prueba2001/UAV-CONTROLADO-POR-4G-LTE/README.md

https://drive.google.com/file/d/1UdGnhi0XhoKIerkP7uhXoAIDbuv5v3hw/view?usp=sharing
Calculos aerodinamicos previos
