prueba2001/UAV-CONTROLADO-POR-4G-LTE/ArchivosCAD/Planos/Ala_huecos_servos.pdf

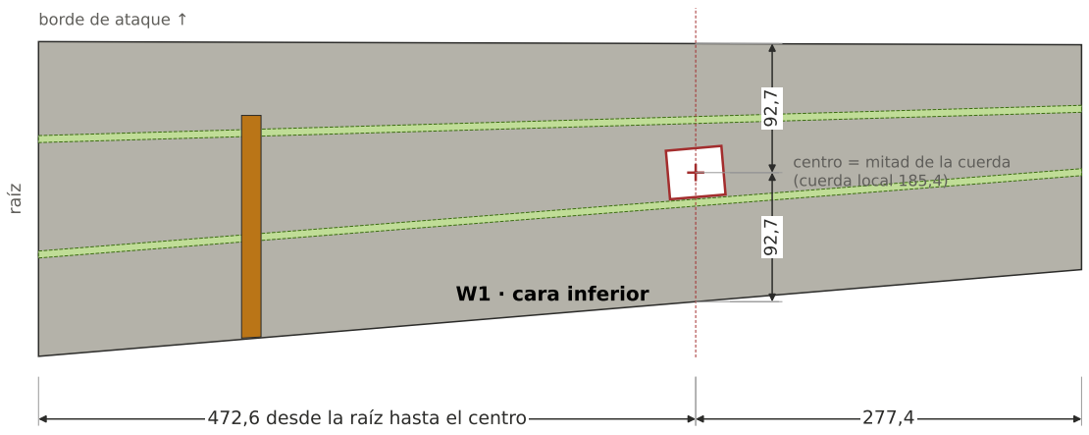
[picture p22: figure]
centro = mitad de la cuerda (cuerda local 185,4); raíz; borde de ataque ↑; W1 · cara inferior

472,6 desde la raíz hasta el centro | 277,4 ⁹²,7 92,7

Escala 1:5

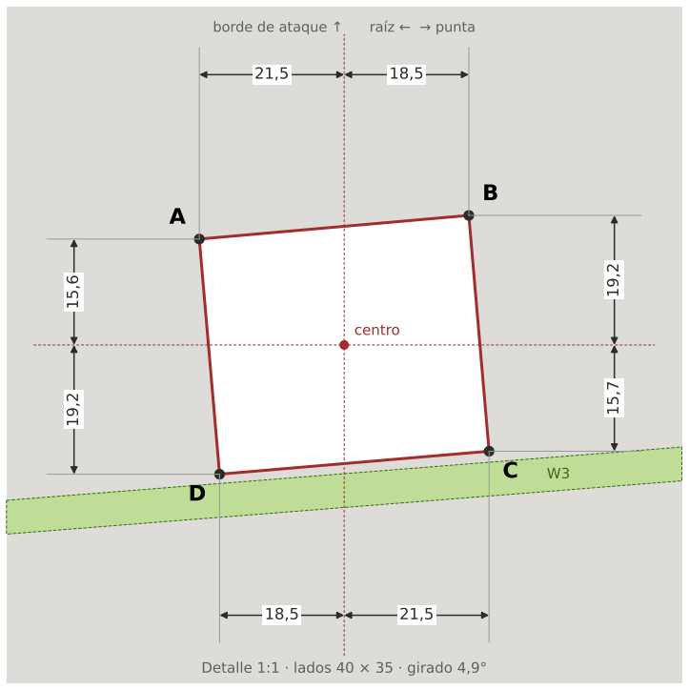
[picture p23: figure]
centro; borde de ataque ↑ raíz ← → punta

Detalle 1:1 · lados 40 × 35 · girado 4,9°

50 mm: imprime al 100 %

# Huecos de los servos de alerón — referencia: centro y vértices

W1 vista desde abajo, borde de ataque arriba. Marca primero el centro y desde él los vértices A, B, C, D.

UAV Alapalap 4S · medidas tomadas del plano A0 de Julius Perdana (Paper Replika) · cotas en mm

## Coordenadas (mm)

Punto | Desde la raíz | Desde el b. de ataque

Desde centro:
hacia la punta

Desde centro:
hacia b. de fuga | Posición
Centro | 472,6 | 92,7 | 0 | 0 | mitad del hueco
A | 451,1 | 77,1 | − 21,5 | − 15,6 | delantero · lado raíz
B | 491,0 | 73,4 | + 18,5 | − 19,2 | delantero · lado punta
C | 494,0 | 108,3 | + 21,5 | + 15,7 | trasero · lado punta
D | 454,1 | 111,8 | − 18,5 | + 19,2 | trasero · lado raíz

Cómo marcarlo en W1 (con la pieza boca abajo)
1. Desde la raíz mide 472,6 mm a lo largo del borde de ataque y traza ahí una línea perpendicular al borde de ataque.
2. Sobre esa línea mide 92,7 mm desde el borde de ataque: ese es el centro. (Comprueba: también debe quedar a 92,7 del borde de fuga.)
3. Desde el centro marca cada vértice con la tabla: primero el desplazamiento hacia la punta (− = hacia la raíz) y luego hacia el borde de fuga (− = hacia adelante).
4. Une A-B-C-D. Comprueba: lados AB y CD = 40, lados BC y DA = 35, y el lado C-D queda paralelo y a 1,5 mm de la franja de W3.
Semiala izquierda: mismos números (la pieza es espejo). Los valores salen del plano A0 y coinciden con el hueco del DXF W1_W5.

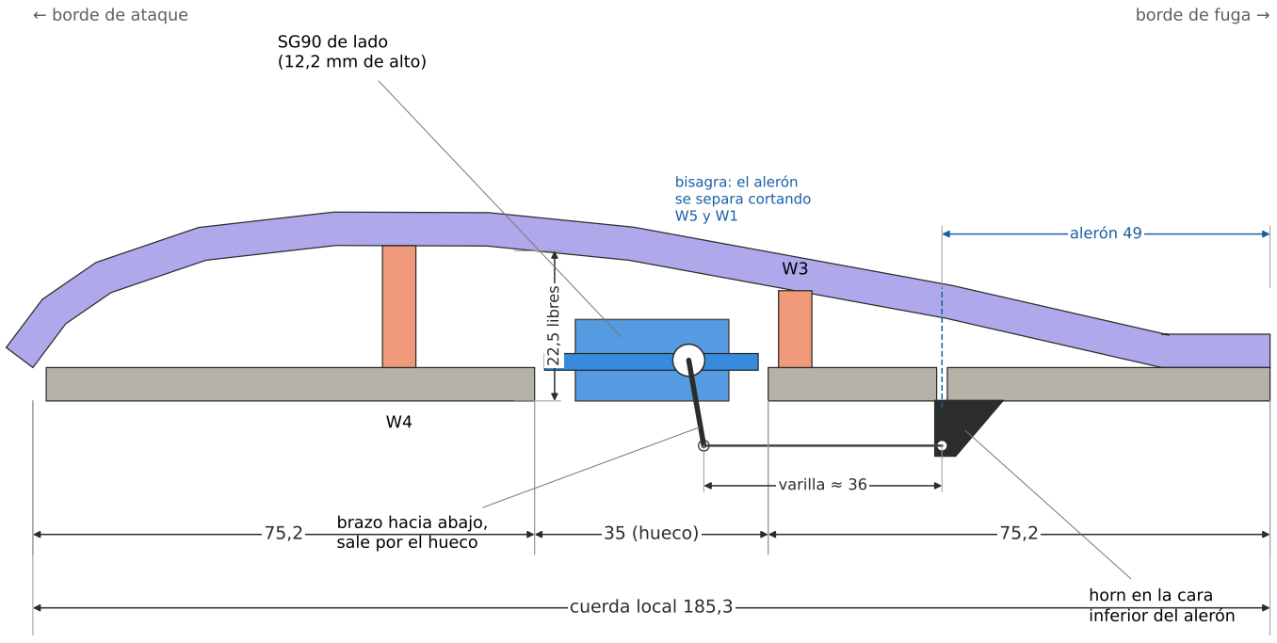
[picture p24: figure]
35 (hueco); cuerda local 185,3; alerón 49; varilla ≈ 36; 22,5 libres; SG90 de lado (12,2 mm de alto); brazo hacia abajo, sale por el hueco; horn en la cara inferior del alerón; bisagra: el alerón se separa cortando W5 y W1; ← borde de ataque; borde de fuga →
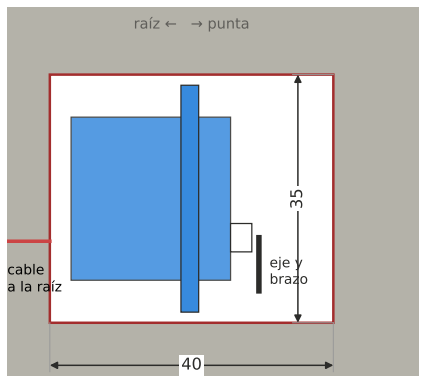
[picture p25: figure]
cable a la raíz; raíz ← → punta; eje y brazo

Vista desde abajo 1:1
(borde de ataque arriba)

Regla de control 50 mm · imprime al 100 %

# Corte por el centro del hueco (a 472,6 mm de la raíz) — escala 1:1

Servo SG90 acostado de lado dentro del hueco: el eje queda horizontal (hacia la punta) y el brazo asoma por debajo para empujar la varilla.

UAV Alapalap 4S · medidas tomadas del plano A0 de Julius Perdana (Paper Replika) · cotas en mm

Por qué de lado: a esa altura de la cuerda el ala tiene entre 17 y 22 mm de alto por dentro (contando el espesor de W1). Un SG90 parado mide 22,7 mm más el eje y no cabe; acostado mide 12,2 mm, entra entero y su base queda a ras de la cara inferior. El hueco de 35 mm (en el sentido de la cuerda) aloja las orejas de 32 mm, y los 40 mm
(en el sentido de la envergadura) alojan el cuerpo de 22,7 mm más el brazo.

Montaje
1. Corta el hueco en W1 antes de pegar W5. Centra el servo antes de instalarlo (90°, con el Pico o un probador de servos).
2. Mete el servo de lado con el eje hacia la punta; pega las orejas a los bordes del hueco con silicona o pegamento caliente a baja temperatura (que se pueda desmontar).
3. Pasa el cable por dentro, entre W4 y W3, hasta la raíz; usa un alargador de 30 cm y abre en W2 una ranura de ≈ 10 × 5 mm para sacarlo hacia la góndola.
4. Pega el horn en la cara inferior del alerón, con sus agujeros alineados con la bisagra y en línea recta con el brazo del servo.
5. Varilla de acero de 1 mm con un doblez en Z en el servo y un clip o doblez en L en el horn. Con el alerón y el servo centrados la varilla queda paralela a la cuerda.
6. Cubre el servo con cinta de embalaje si quieres protegerlo del polvo; deja libre el brazo.
Ubicación tomada del plano A0 (hueco 40 × 35 de W1). El corte y la posición del horn son esquemáticos; las cotas en planta son las del plano.
