prueba2001/UAV-CONTROLADO-POR-4G-LTE/ArchivosCAD/Planos/Gondola_brochetas_ligas.pdf

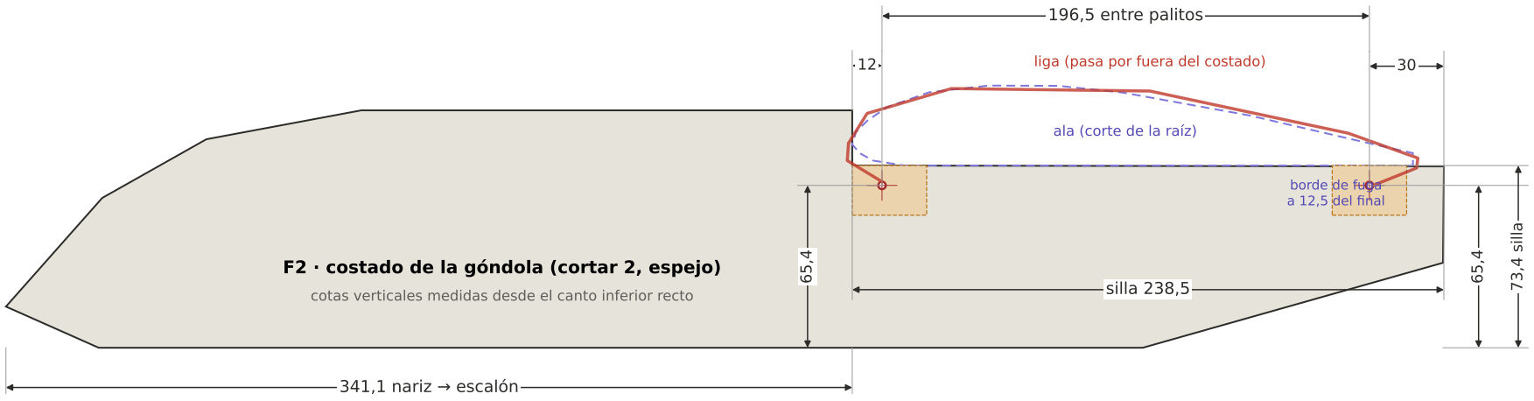
[picture p26: figure]
ala (corte de la raíz); liga (pasa por fuera del costado); 341,1 nariz → escalón; silla 238,5; 196,5 entre palitos; 73,4 silla; borde de fuga a 12,5 del final

# F2 · costado de la góndola (cortar 2, espejo)

cotas verticales medidas desde el canto inferior recto

12

8
silla

Ø 3 · refuerzo opcional 30 × 20

## Detalle 1:1 · palito delantero

30

8

Ø 3 · refuerzo opcional 30 × 20

## Detalle 1:1 · palito trasero

# Perforaciones para los palitos de las ligas — costado F2 de la góndola

Escala 1:2,5. F2 visto desde afuera (nariz a la izquierda). Como en el video: las dos brochetas en la zona de la silla, a la misma altura, 8 mm bajo su canto (según las fotos del video).

UAV Alapalap 4S · medidas tomadas del plano A0 de Julius Perdana (Paper Replika) · cotas en mm

# Centros de las perforaciones en F2 (mm)

Palito | Horizontal | Desde el canto inferior

## Desde la línea de la silla

Delantero | 12 detrás del escalón
(353,1 desde la nariz)
65,4 | 8 por debajo
Trasero | 30 antes del final

(549,6 desde la nariz)

65,4 | 8 por debajo

Palitos: brochetas de bambú de 3 mm, como en el video. Agujero Ø 3 (pásalo con la misma brocheta o una broca de 3). Refuerzo opcional: contrachapado 2 mm por dentro (30 × 20 en cada brocheta); Julius pasa la brocheta directo por el Depron. Atrás: deja al menos 5 mm libres entre la brocheta y el soporte del motor.
Las ligas abrazan el borde de ataque y el de fuga; el ala va contra el escalón.

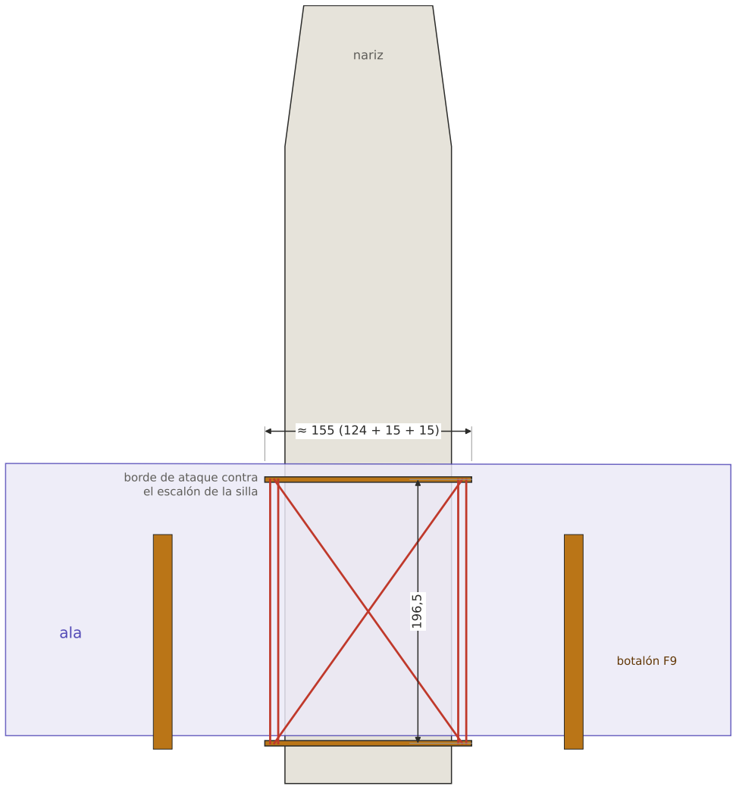
[picture p27: figure]
borde de ataque contra el escalón de la silla; ala; nariz; botalón F9

motor y hélice detrás

Escala 1:4 · 4 a 6 ligas: 2 rectas por lado + 2 cruzadas en X

## Corte por las brochetas (zona de la silla) · 1:2

# Palitos y ligas — vista de arriba (1:4) y corte de la góndola (1:2)

Las brochetas atraviesan los dos costados F2 y sobresalen 15 mm a cada lado. Las ligas van de una a otra por encima del ala.

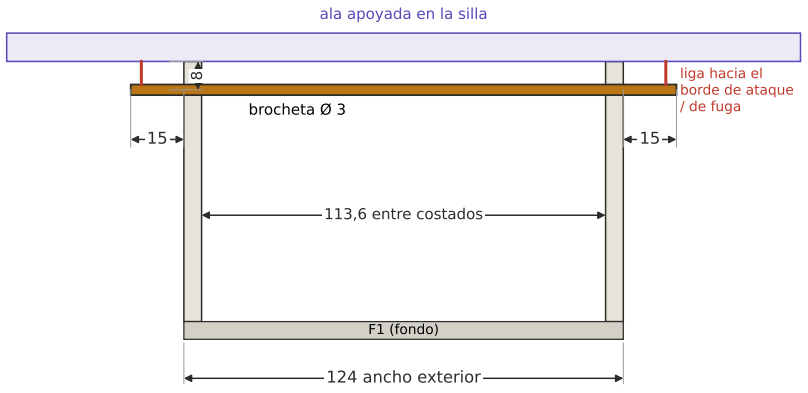
[picture p28: figure]
ala apoyada en la silla; liga hacia el borde de ataque / de fuga; 124 ancho exterior; 113,6 entre costados; brocheta Ø 3; F1 (fondo)

UAV Alapalap 4S · medidas tomadas del plano A0 de Julius Perdana (Paper Replika) · cotas en mm

Cómo hacerlo (como en el video)
1. Arma la góndola. Marca los centros en los dos costados con la tabla: adelante 12 mm
detrás del escalón, atrás 30 mm antes del final (delante del soporte del motor); las dos a 8 mm bajo la silla.
2. Atraviesa los dos costados con la brocheta (o broca de 3 mm), mirando desde arriba
que quede perpendicular a la góndola.
3. Corta la brocheta dejando 15 mm afuera por lado (≈ 155 mm de largo total).
4. Fíjala con una gota de pegamento caliente o CA en cada costado.
5. Apoya el ala con el borde de ataque contra el escalón y pon 4 a 6 ligas.
6. Las ligas abrazan el borde de ataque y el de fuga: pon cinta en esos bordes para que no corten el Depron.
7. Por dentro, pasa los cables por encima o por debajo de las brochetas antes de meterlas.
