prueba2001/UAV-CONTROLADO-POR-4G-LTE/ArchivosCAD/Planos/Ala_Alapalap_corte_y_caras.pdf

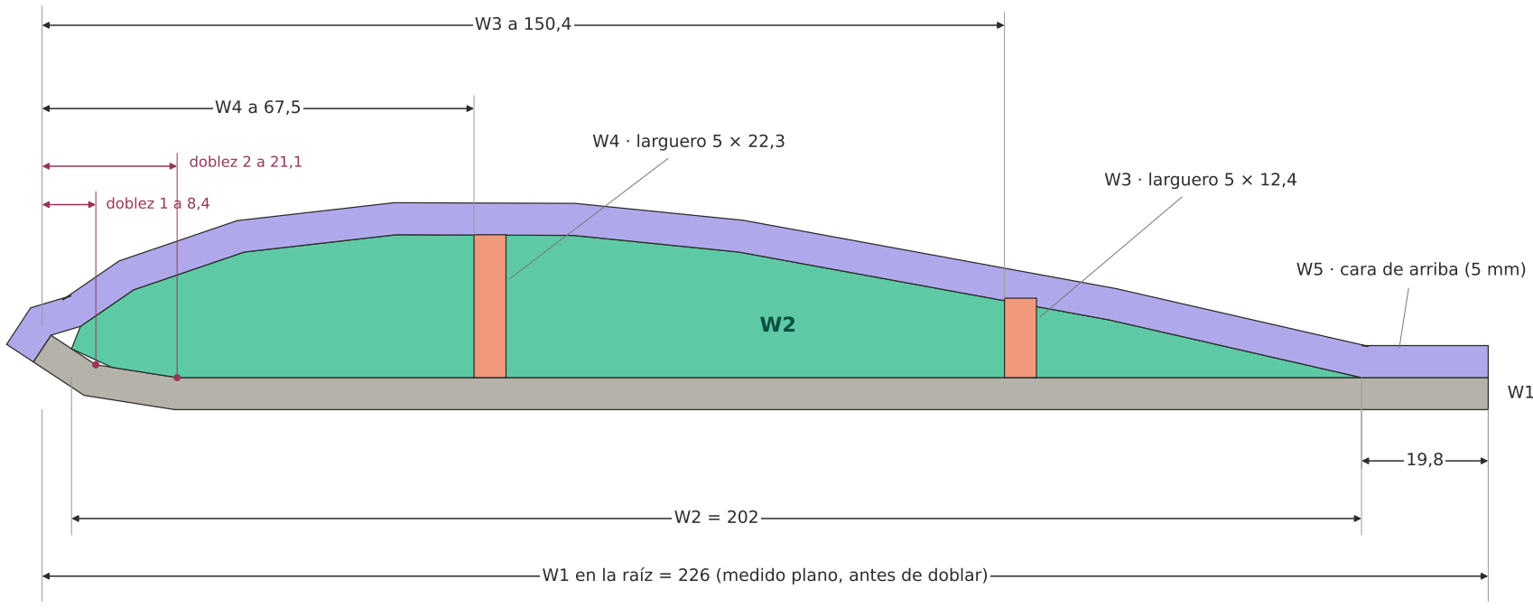
[picture p29: figure]
doblez 2 a 21,1; doblez 1 a 8,4; W4 · larguero 5 × 22,3; W3 · larguero 5 × 12,4; W5 · cara de arriba (5 mm)

W1 en la raíz = 226 (medido plano, antes de doblar)

W1 · cara de abajo (5 mm)

← Borde de ataque | Borde de fuga →

Regla de control: 50 mm exactos

Orden de armado
1. Marca en W1 los dobleces a 8,4 y 21,1 mm del borde de ataque (en la punta: 5,9 y 13,7). Dobla el frente hacia arriba con suavidad.
2. Pega W4 y W3 sobre sus franjas punteadas.
3. W2 en la raíz: su base plana empieza sobre el doblez 2;
la nariz apoya en el frente doblado de W1.
4. Presenta W5 en seco y pégala desde el borde de ataque,
doblándola sobre sus 7 líneas de doblez.
El frente doblado de W1 sostiene la nariz curva de W2; W5 lo envuelve y cubre su canto.

# Corte de la raíz del ala — escala 1:1

Imprime al 100 % ("tamaño real", sin "ajustar a página") y comprueba con la regla de 50 mm. Sirve como plantilla para presentar las piezas.

UAV Alapalap 4S · medidas tomadas del plano A0 de Julius Perdana (Paper Replika) · cotas en mm

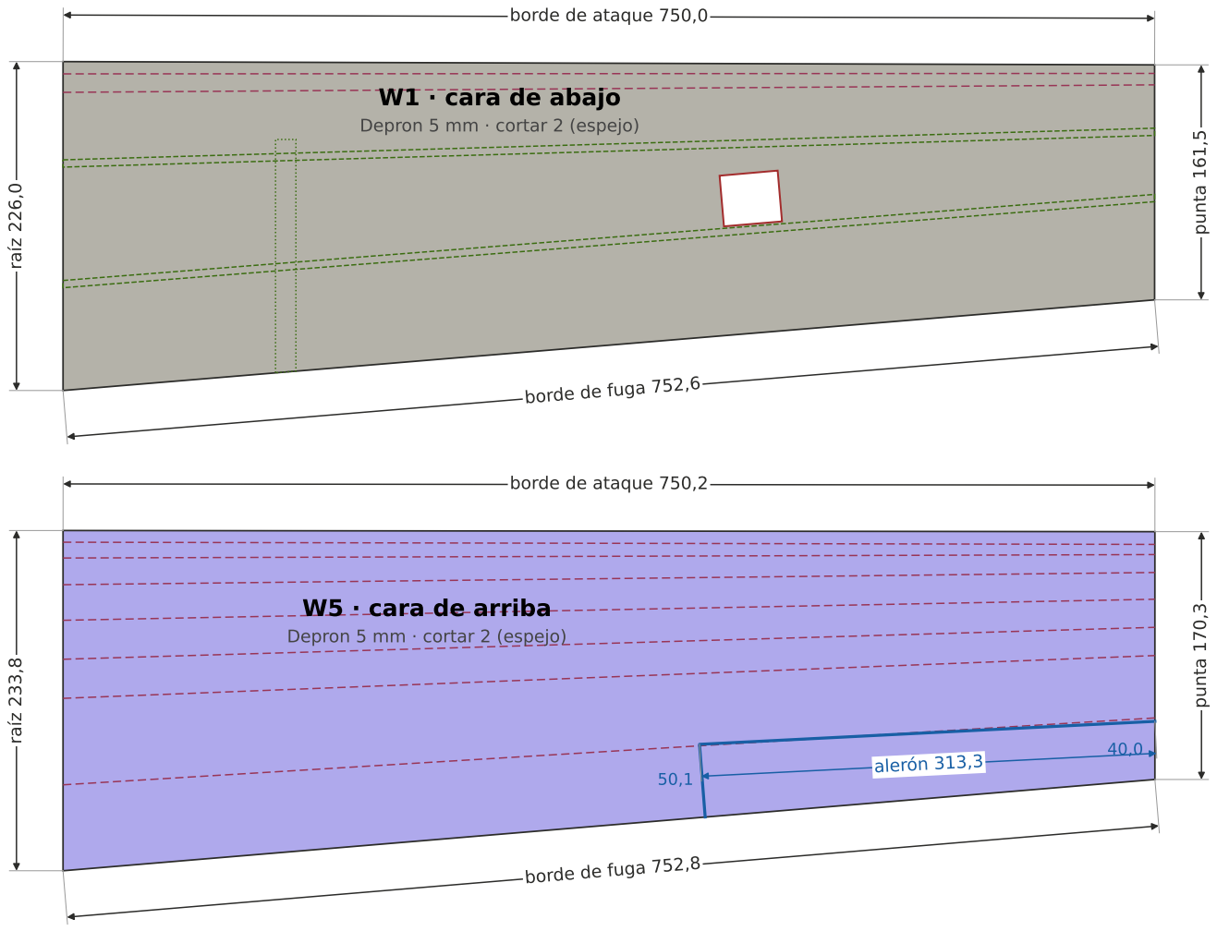
[picture p30: figure]
W1 · cara de abajo; Depron 5 mm · cortar 2 (espejo); W5 · cara de arriba; raíz 226,0; punta 161,5; borde de ataque 750,0; borde de fuga 752,6; raíz 233,8; punta 170,3; borde de ataque 750,2; borde de fuga 752,8; alerón 313,3 50,1

raíz

punta

raíz

punta

Medida | W1 abajo | W5 arriba
Raíz | 226,0 | 233,8
Punta | 161,5 | 170,3
Borde de ataque | 750,0 | 750,2
Borde de fuga | 752,6 | 752,8
Envergadura | 750 | 750

W5 es más ancha porque se curva
sobre W2 y envuelve el borde de ataque.

W1 cara de abajo

W5 cara de arriba

franjas de largueros W4 / W3

posición del botalón F9

hueco 40 × 35 (cortar)

corte del alerón

líneas de doblez

# Caras del ala en planta — escala 1:4,5

Una semiala: W1 (cara de abajo) y W5 (cara de arriba). Corta 2 de cada una; para la otra semiala voltea la pieza (espejo).

# Ubicación de los botalones F9 en la cara inferior del ala

Vista desde abajo. Medidas desde la línea de unión central (raíz de W1) y desde el borde de ataque, tomadas del recuadro "GLUE BOOM HERE" del plano A0.

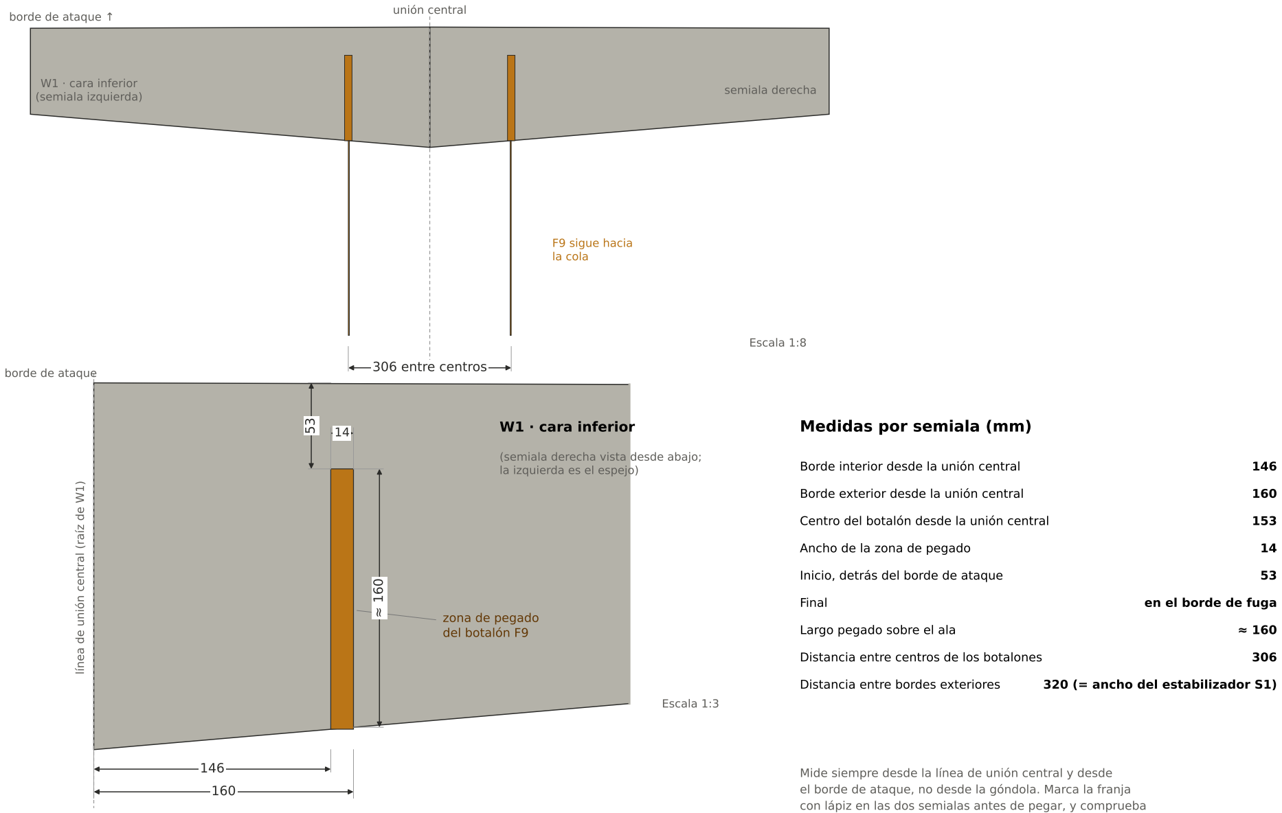
[picture p31: figure]
unión central; 306 entre centros; W1 · cara inferior; (semiala izquierda); semiala derecha; F9 sigue hacia la cola; borde de ataque ↑; Escala 1:8; zona de pegado del botalón F9; línea de unión central (raíz de W1); (semiala derecha vista; desde abajo;; la izquierda es el espejo); borde de ataque; Escala 1:3; Medidas por semiala (mm); Ancho de la zona de pegado; Inicio, detrás del borde de ataque; Final; en el borde de fuga; Largo pegado sobre el ala

Borde interior desde la unión central | 146
Borde exterior desde la unión central | 160
Centro del botalón desde la unión central | 153
Distancia entre centros de los botalones | 306
Distancia entre bordes exteriores | 320 (= ancho del estabilizador S1)

Mide siempre desde la línea de unión central y desde
el borde de ataque, no desde la góndola. Marca la franja con lápiz en las dos semialas antes de pegar, y comprueba que ambos botalones queden paralelos entre sí.

# Vista superior

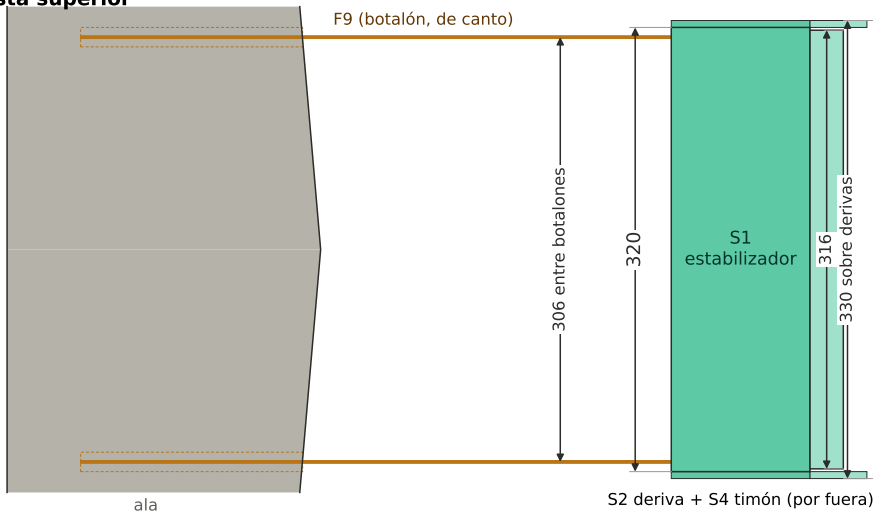
[picture p32: figure]
ala; S1 estabilizador; F9 (botalón, de canto); 306 entre botalones; 330 sobre derivas; S2 deriva + S4 timón (por fuera)

# Vista lateral (lado izquierdo)

# Montaje de la cola sobre los botalones F9

Medidas en mm desde el borde de ataque del ala (raíz) y desde la punta delantera de F9. Dibujo proporcional: usa las cotas, no midas sobre el papel.

Cómo va la cola
- F9 va de canto bajo el ala: el extremo ancho

(28,5) adelante, el angosto (13,9) atrás.
- S1 se apoya sobre el extremo trasero de los dos

botalones; su borde de fuga coincide con el final de F9 (bisagra de S3 = fin del botalón).
- S1 mide 320: sobresale 6 mm por fuera de

cada botalón (306 entre centros).
- S3 (316) va con bisagra de cinta tras S1.
- Las derivas S2 se pegan en las puntas de S1;

su cuerda máxima (100) coincide con S1 y su parte inferior (50) baja como patín.
- S4 (timón) con bisagra en el borde trasero

de cada S2, alineado con la bisagra de S3.

Deducido de las medidas de las piezas del plano, que no trae dibujo de montaje: confírmalo con el video de Julius Perdana antes de pegar.

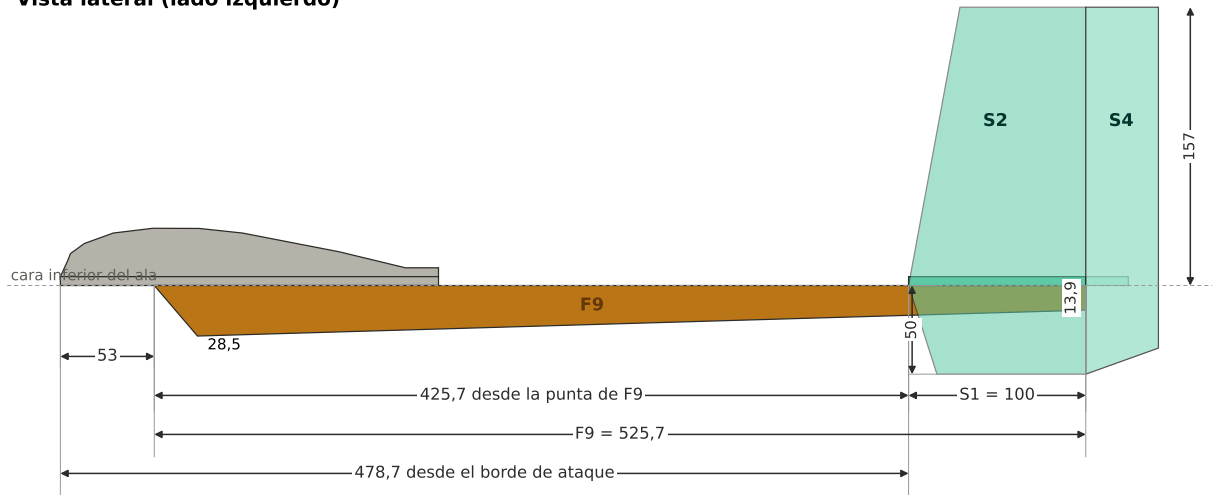
[picture p33: figure]
cara inferior del ala; 425,7 desde la punta de F9; 478,7 desde el borde de ataque
