prueba2001/UAV-CONTROLADO-POR-4G-LTE/Resources/Software/Imagenes/diagramas/05_recorrido_comando.png

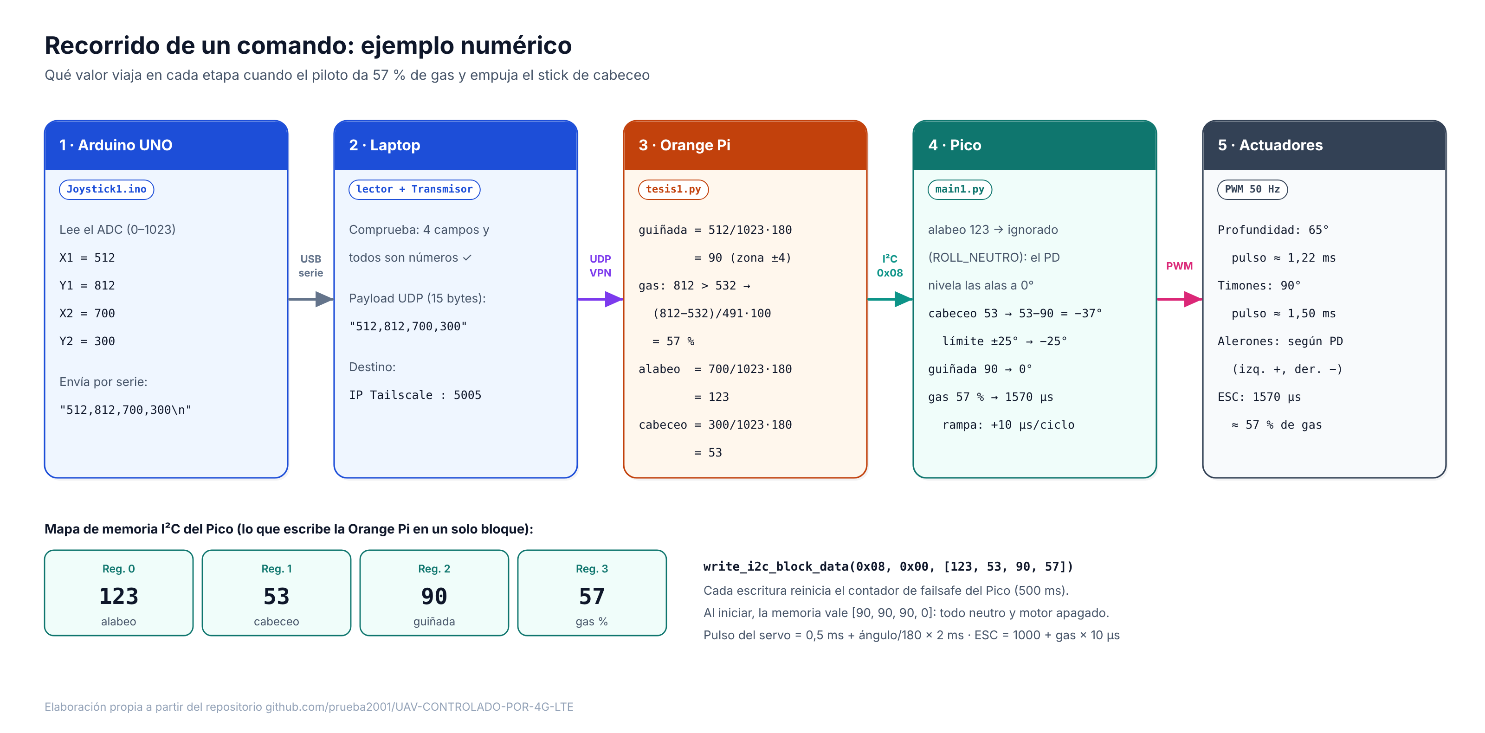
Resources/Software/Imagenes/diagramas/05_recorrido_comando.png
