prueba2001/UAV-CONTROLADO-POR-4G-LTE/Resources/Software/Imagenes/diagramas/06_flujo_codigo_tierra.png

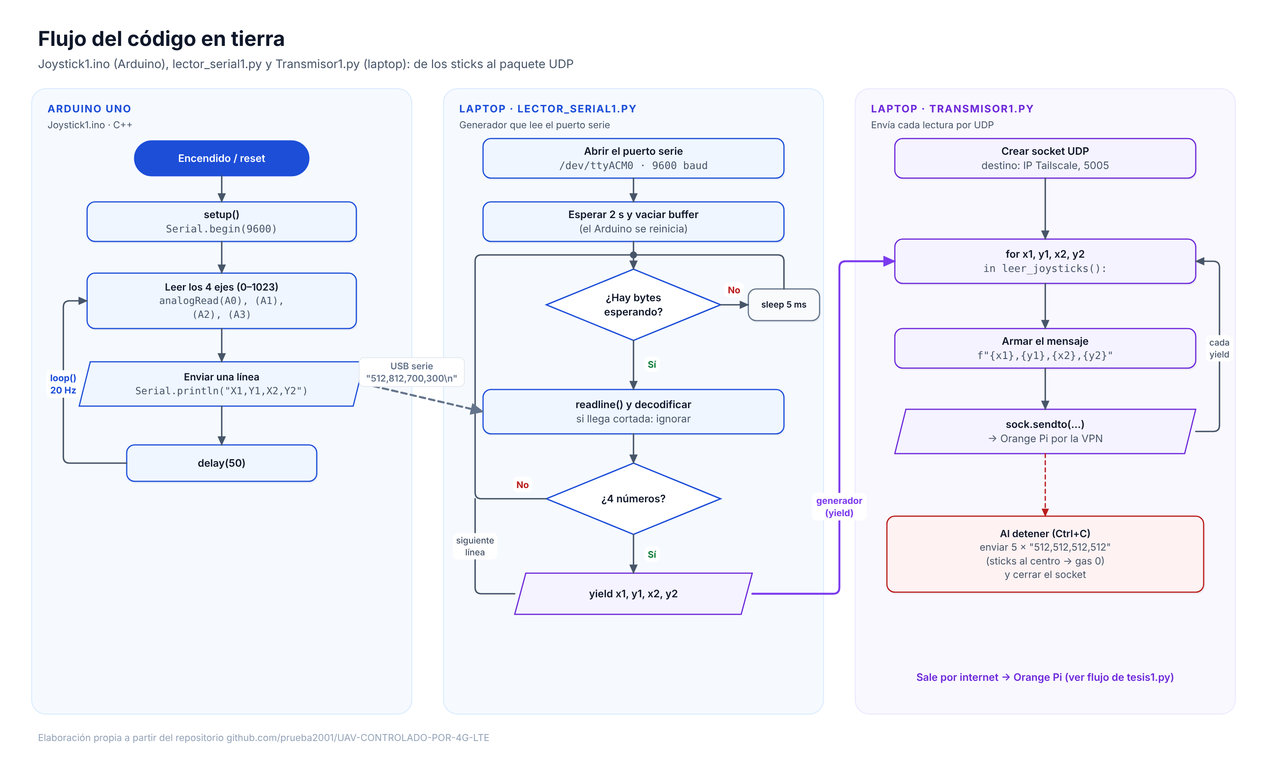
Resources/Software/Imagenes/diagramas/06_flujo_codigo_tierra.png
