prueba2001/UAV-CONTROLADO-POR-4G-LTE/Resources/Software/Imagenes/diagramas/10_linea_tiempo_failsafe.png

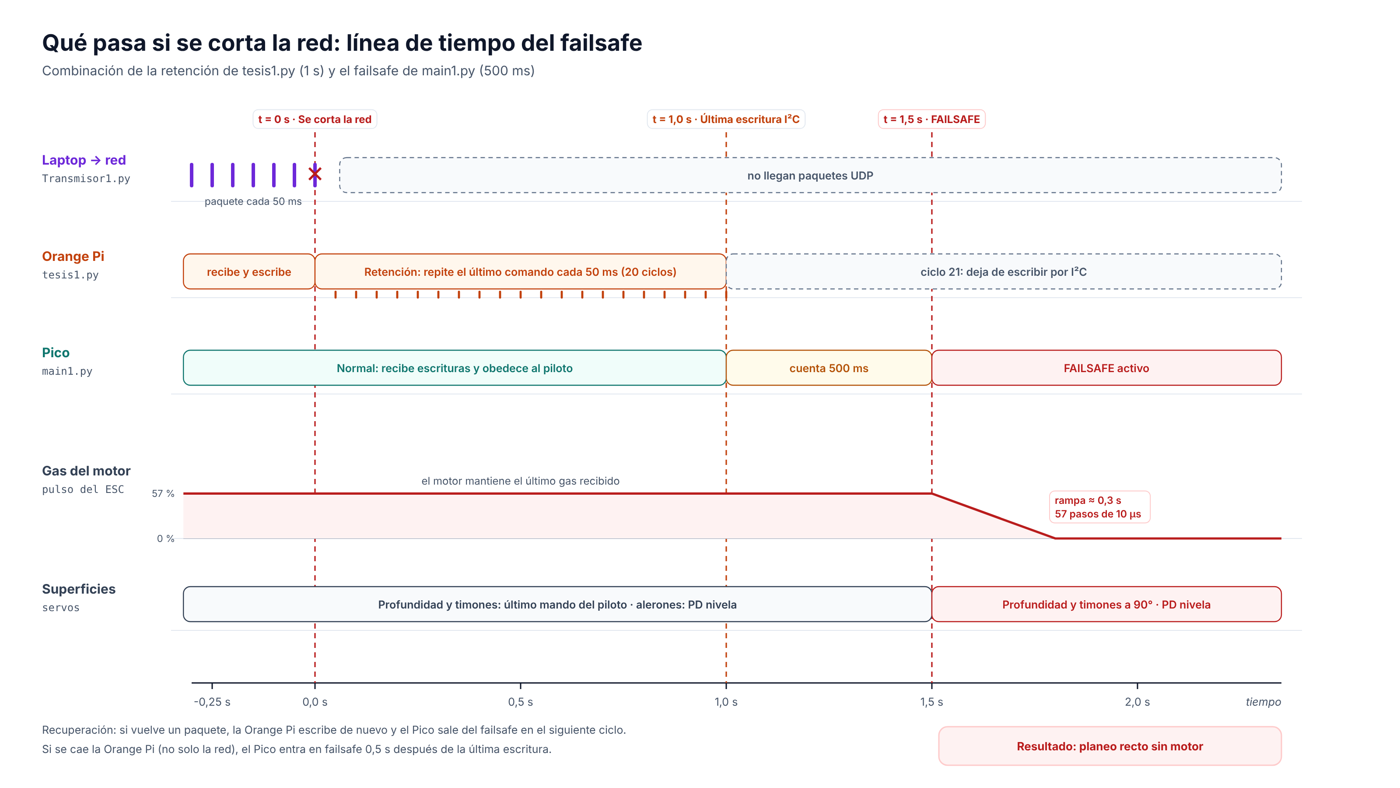
Resources/Software/Imagenes/diagramas/10_linea_tiempo_failsafe.png
