prueba2001/UAV-CONTROLADO-POR-4G-LTE/ArchivosCAD/DXF/F9_tail_boom.dxf

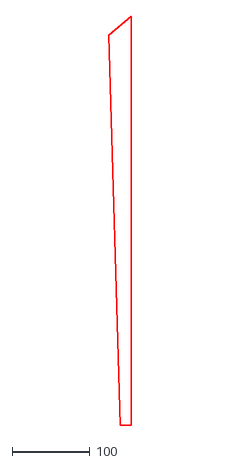
[picture p37: CAD file, 2026-10-21]
ArchivosCAD/DXF/F9_tail_boom.dxf
28.5 x 525.7
