prueba2001/UAV-CONTROLADO-POR-4G-LTE/ArchivosCAD/FreeCAD/Alapalap_4S.step

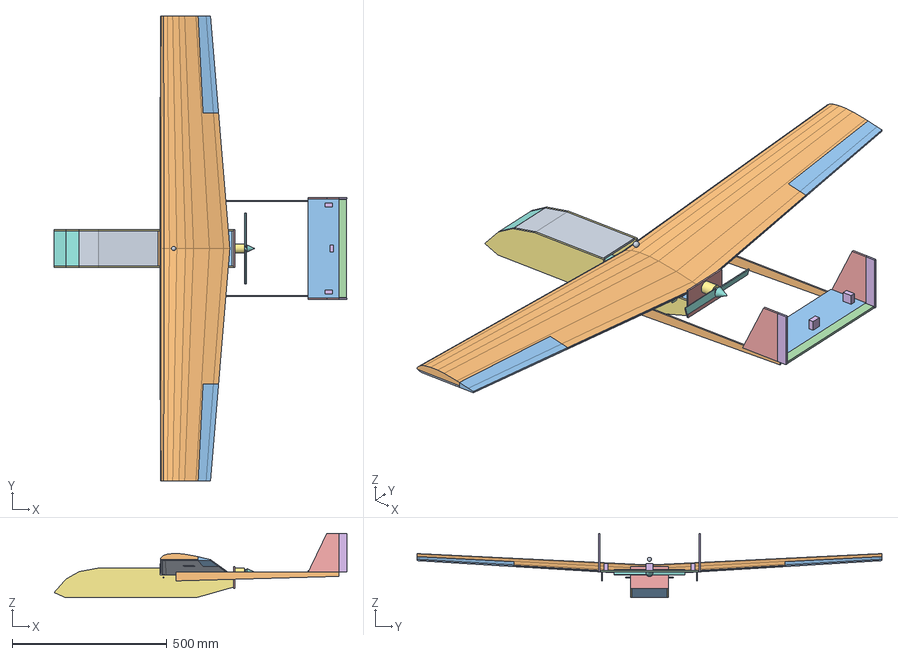
[picture p38: CAD file, 2026-11-01]
ArchivosCAD/FreeCAD/Alapalap_4S.step
944.8 x 1500.0 x 207.7 mm
W1 cara inferior derecha
W5 cara superior derecha
Aleron derecha (313,3 x 50,1-40)
Larguero W4 derecha
Larguero W3 derecha
W1 cara inferior izquierda
W5 cara superior izquierda
Aleron izquierda (313,3 x 50,1-40)
Larguero W4 izquierda
Larguero W3 izquierda
W6 union central (contrachapado)
W2 formador raiz derecha
W2 formador raiz izquierda
F9 botalon derecho (525,7 x 28,5/13,9)
F9 botalon izquierdo (525,7 x 28,5/13,9)
S1 estabilizador (320 x 100)
S3 profundidad (316 x 24)
S2 deriva derecha (forma deducida)
S4 timon derecha (deducido)
S2 deriva izquierda (forma deducida)
S4 timon izquierda (deducido)
F2 costado derecho (579,6)
F2 costado izquierdo (579,6)
Nariz (deducida)
Tapa de la gondola (deducida)
F1 fondo
Fondo trasero (deducido)
Brocheta del (bambu 3 x 155)
Brocheta tras (bambu 3 x 155)
Soporte del motor (deducido)
LiPo 4S 3300 mAh (mover hasta CG = 45)
Orange Pi 4 Pro
Disipador Orange Pi
MPU6050 (cerca del CG)
RPi Pico control (I2C 0x08)
RPi Pico sensores MQ
Modem LTE
ESC
UBEC 5 V
SG90 aleron derecho
SG90 timon derecho (orientativo)
SG90 aleron izquierdo
SG90 timon izquierdo (orientativo)
SG90 profundidad (orientativo)
Motor brushless 4S 920 kV
Helice propulsora 9 pulg. (supuesta)
Centro de gravedad (45 tras el BA)
