prueba2001/UAV-CONTROLADO-POR-4G-LTE/ArchivosCAD/FreeCAD/STL/Brocheta_del.stl

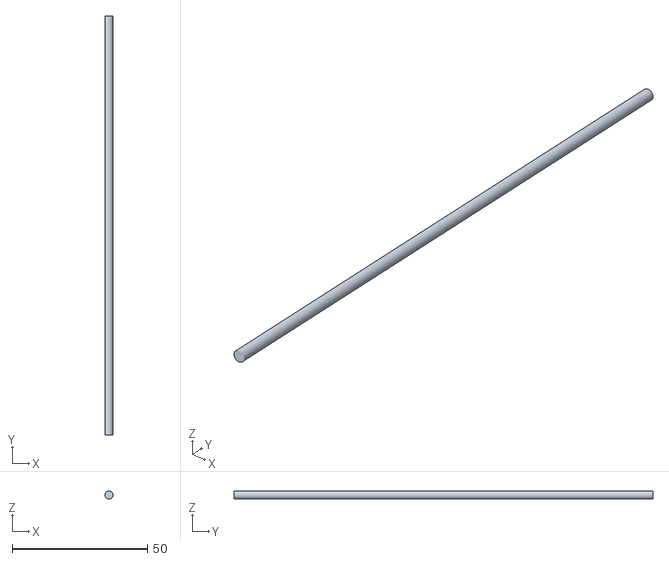
[picture p39: CAD file, 2026-11-01]
ArchivosCAD/FreeCAD/STL/Brocheta_del.stl
3.00 x 155.0 x 3.00
