prueba2001/UAV-CONTROLADO-POR-4G-LTE/ArchivosCAD/DXF/F9x2_W6.dxf

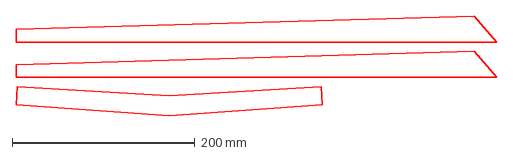
[picture p40: CAD file, 2026-10-21]
ArchivosCAD/DXF/F9x2_W6.dxf
525.7 x 109.2 mm
