prueba2001/UAV-CONTROLADO-POR-4G-LTE/ArchivosCAD/FreeCAD/STL/Nariz.stl

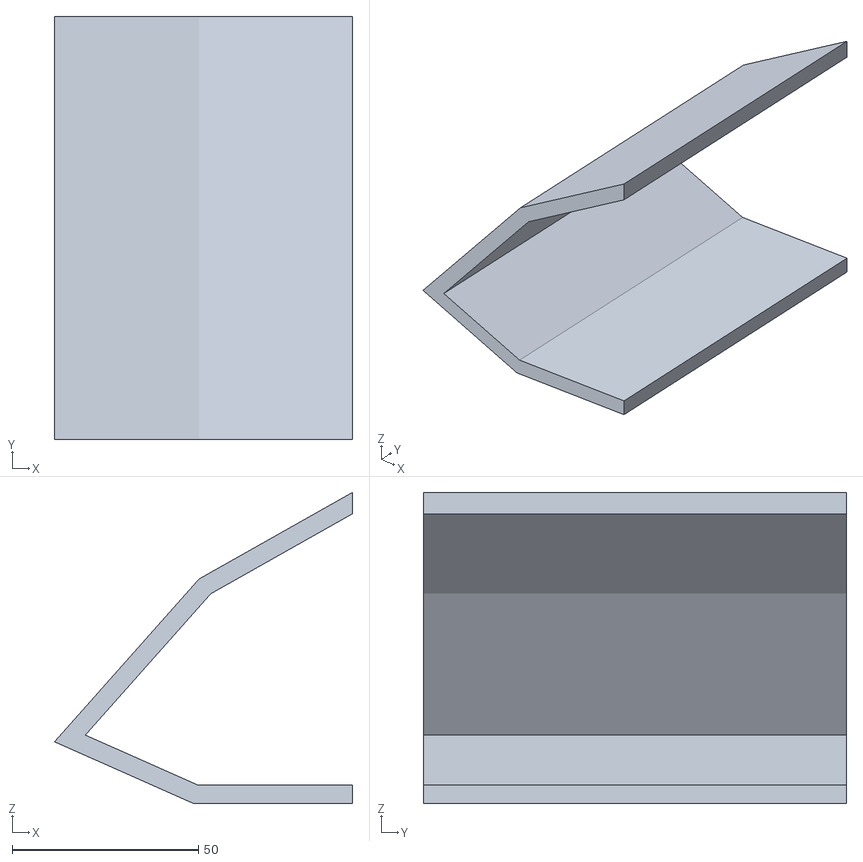
[picture p41: CAD file, 2026-11-01]
ArchivosCAD/FreeCAD/STL/Nariz.stl
80.0 x 113.6 x 83.5
