prueba2001/UAV-CONTROLADO-POR-4G-LTE/ArchivosCAD/FreeCAD/STL/S1.stl

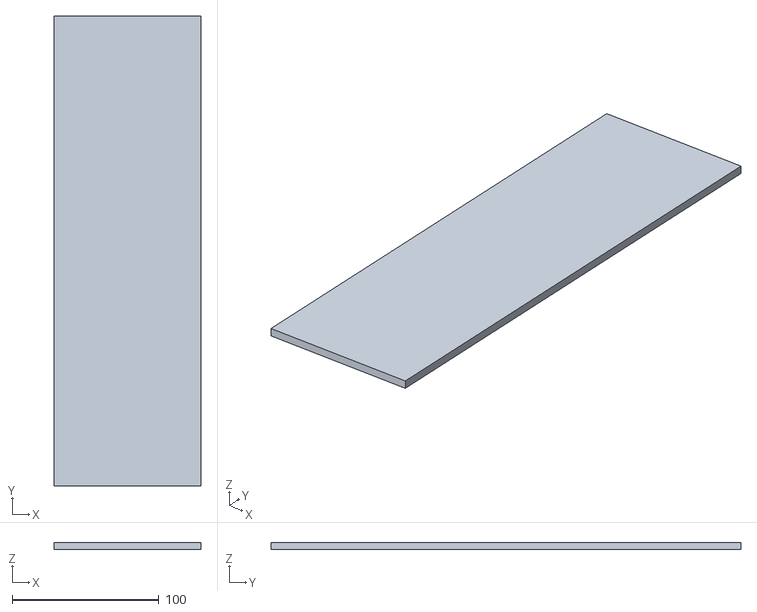
[picture p42: CAD file, 2026-11-01]
ArchivosCAD/FreeCAD/STL/S1.stl
100.0 x 320.0 x 5.00
