prueba2001/UAV-CONTROLADO-POR-4G-LTE/ArchivosCAD/FreeCAD/STL/S4_I.stl

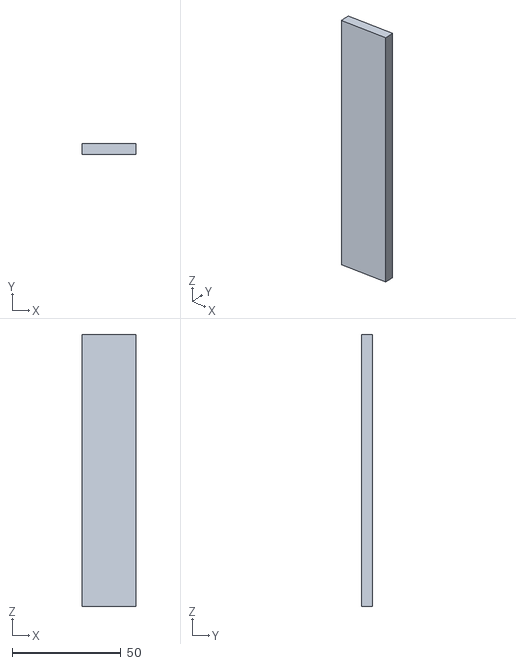
[picture p43: CAD file, 2026-11-01]
ArchivosCAD/FreeCAD/STL/S4_I.stl
25.0 x 5.00 x 125.0
