prueba2001/UAV-CONTROLADO-POR-4G-LTE/ArchivosCAD/FreeCAD/STL/Servo_aleron_D.stl

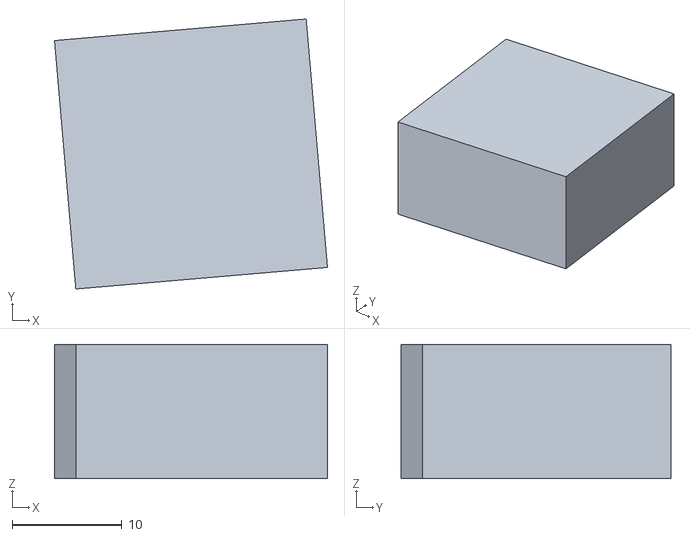
[picture p44: CAD file, 2026-11-01]
ArchivosCAD/FreeCAD/STL/Servo_aleron_D.stl
24.9 x 24.6 x 12.2
