prueba2001/UAV-CONTROLADO-POR-4G-LTE/ArchivosCAD/FreeCAD/STL/F2_D.stl

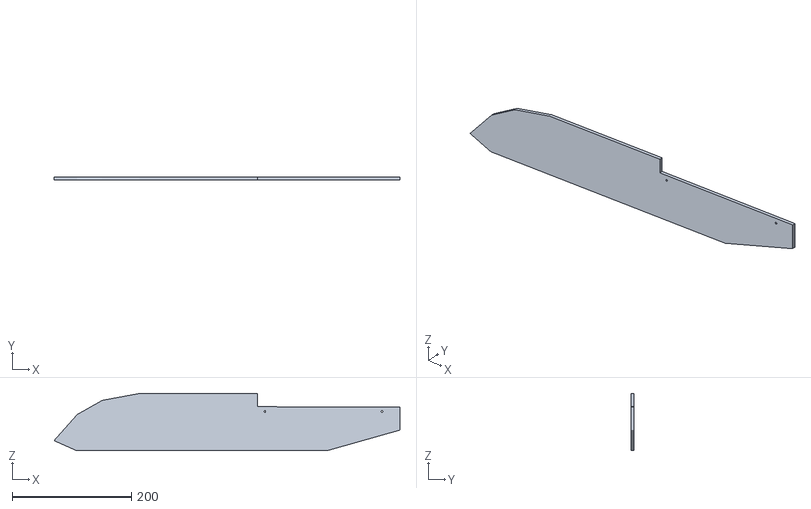
[picture p45: CAD file, 2026-11-01]
ArchivosCAD/FreeCAD/STL/F2_D.stl
579.6 x 5.20 x 95.6
