prueba2001/UAV-CONTROLADO-POR-4G-LTE/ArchivosCAD/FreeCAD/STL/W3_I.stl

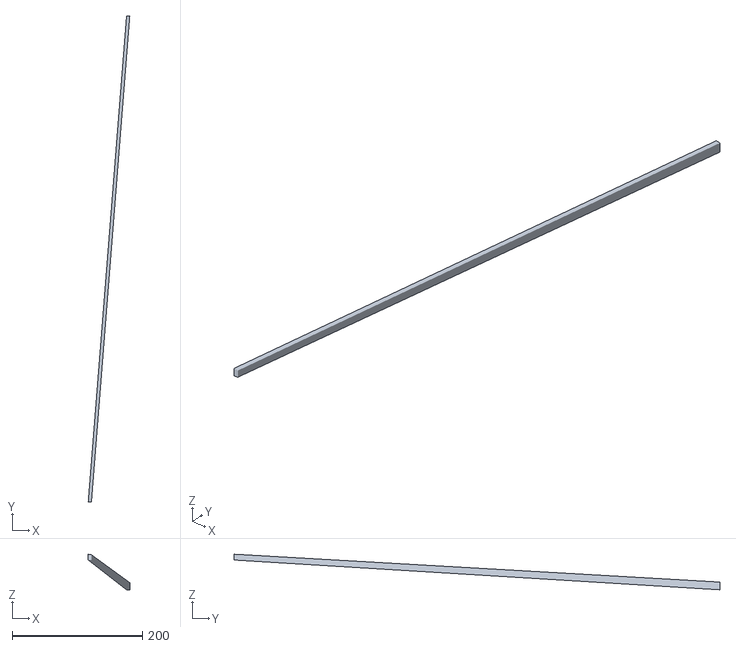
[picture p46: CAD file, 2026-11-01]
ArchivosCAD/FreeCAD/STL/W3_I.stl
63.8 x 745.0 x 54.6
