prueba2001/UAV-CONTROLADO-POR-4G-LTE/ArchivosCAD/FreeCAD/STL/CG.stl

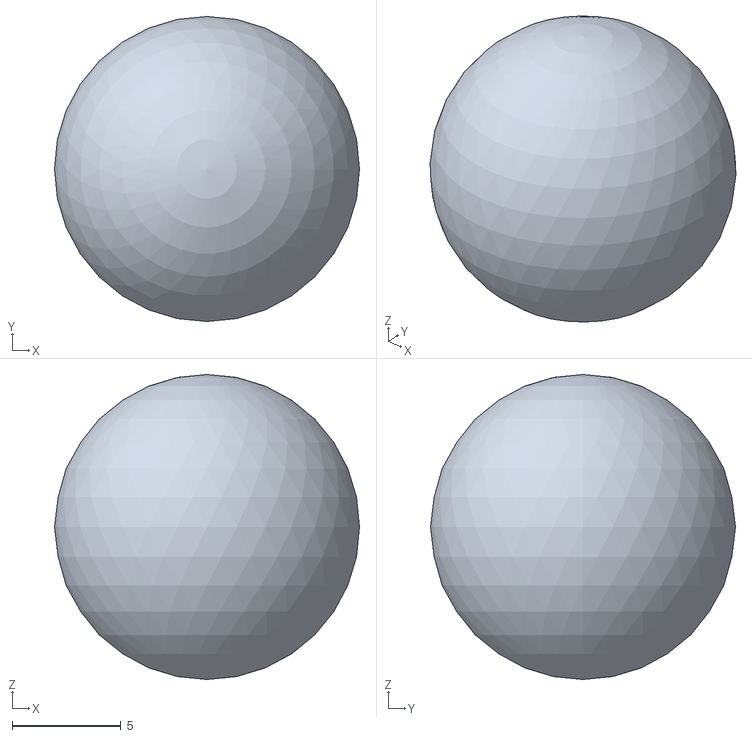
[picture p47: CAD file, 2026-11-01]
ArchivosCAD/FreeCAD/STL/CG.stl
14.0 x 14.0 x 14.0
