prueba2001/UAV-CONTROLADO-POR-4G-LTE/ArchivosCAD/FreeCAD/STL/W6.stl

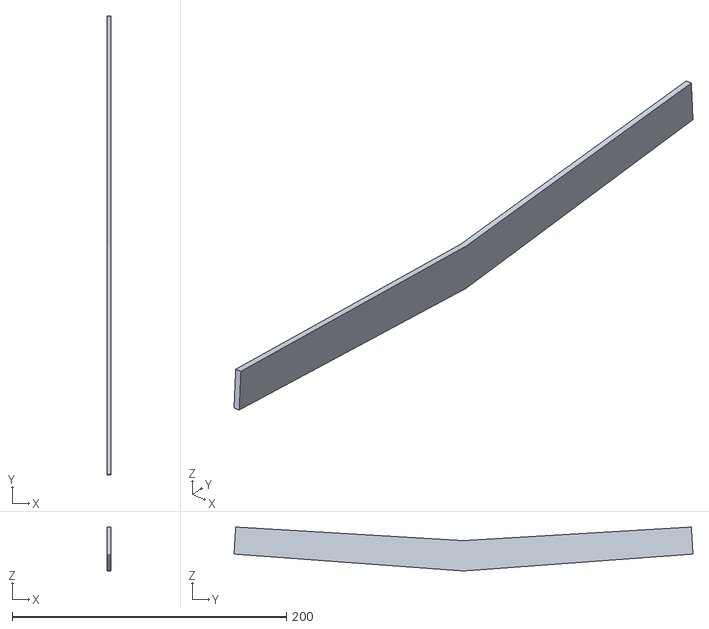
[picture p48: CAD file, 2026-11-01]
ArchivosCAD/FreeCAD/STL/W6.stl
3.00 x 334.9 x 32.1
