prueba2001/UAV-CONTROLADO-POR-4G-LTE/ArchivosCAD/FreeCAD/STL/W2_I.stl

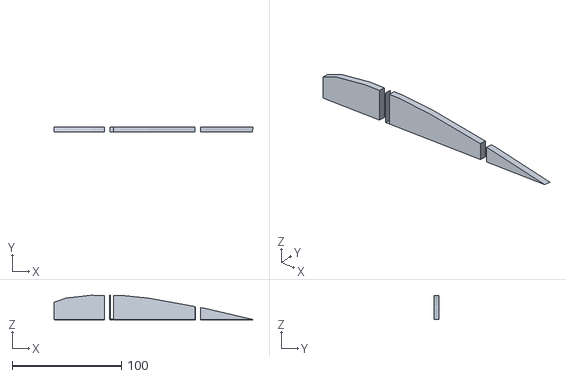
[picture p49: CAD file, 2026-11-01]
ArchivosCAD/FreeCAD/STL/W2_I.stl
182.2 x 5.00 x 22.4
