prueba2001/UAV-CONTROLADO-POR-4G-LTE/ArchivosCAD/FreeCAD/STL/S2_D.stl

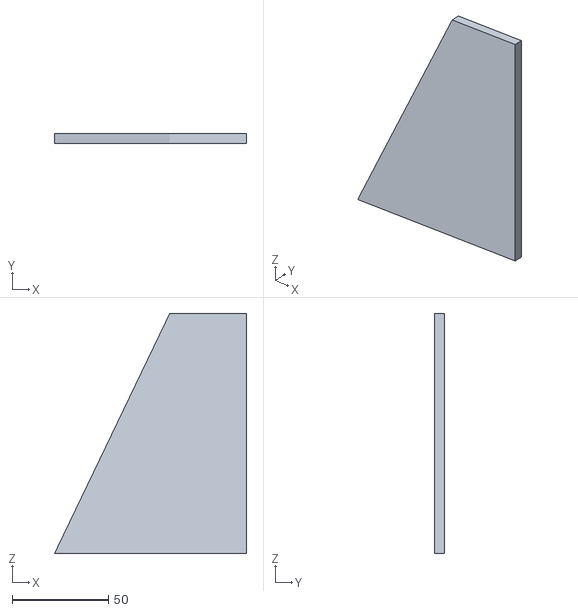
[picture p50: CAD file, 2026-11-01]
ArchivosCAD/FreeCAD/STL/S2_D.stl
100.0 x 5.00 x 125.0
