prueba2001/UAV-CONTROLADO-POR-4G-LTE/ArchivosCAD/FreeCAD/STL/Fondo_trasero.stl

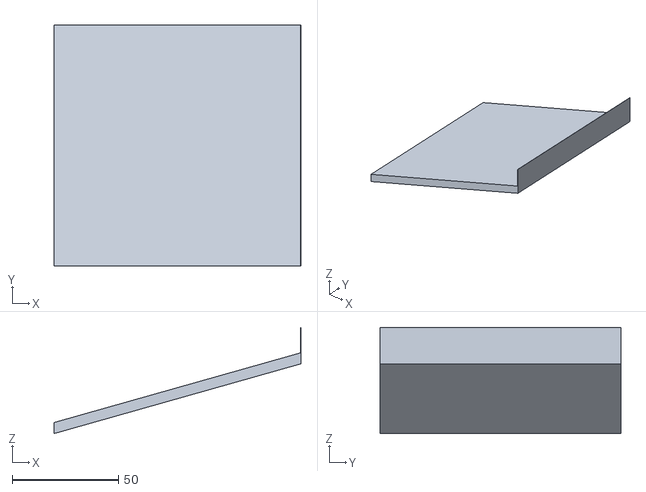
[picture p51: CAD file, 2026-11-01]
ArchivosCAD/FreeCAD/STL/Fondo_trasero.stl
116.3 x 113.6 x 50.0
