prueba2001/UAV-CONTROLADO-POR-4G-LTE/ArchivosCAD/FreeCAD/STL/Aleron_D.stl

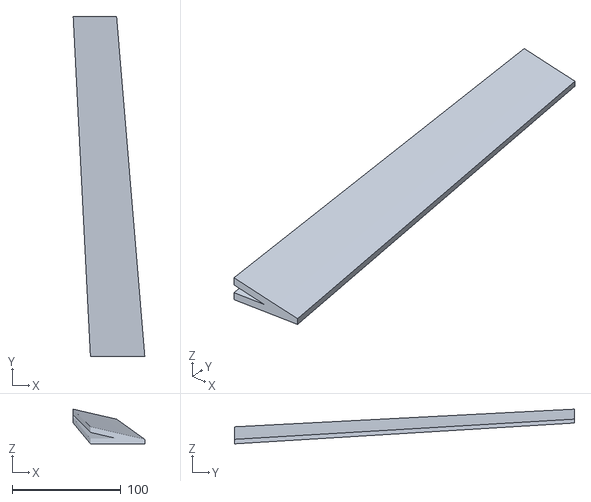
[picture p52: CAD file, 2026-11-01]
ArchivosCAD/FreeCAD/STL/Aleron_D.stl
66.0 x 313.0 x 32.0
