prueba2001/UAV-CONTROLADO-POR-4G-LTE/ArchivosCAD/FreeCAD/STL/S3.stl

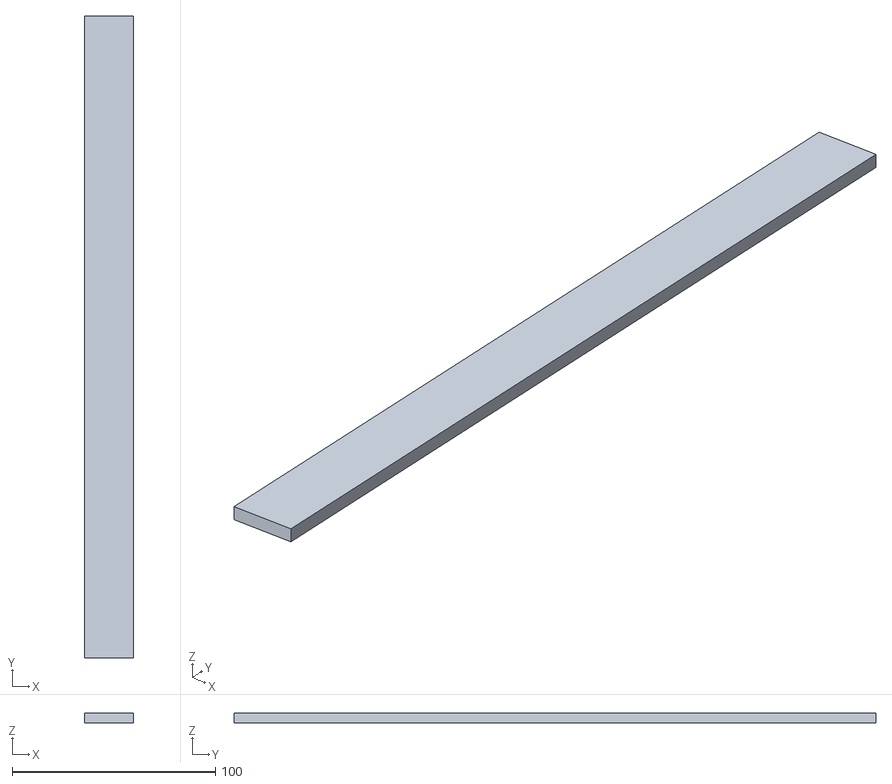
[picture p53: CAD file, 2026-11-01]
ArchivosCAD/FreeCAD/STL/S3.stl
24.0 x 316.0 x 5.00
