prueba2001/UAV-CONTROLADO-POR-4G-LTE/ArchivosCAD/FreeCAD/STL/W1_I.stl

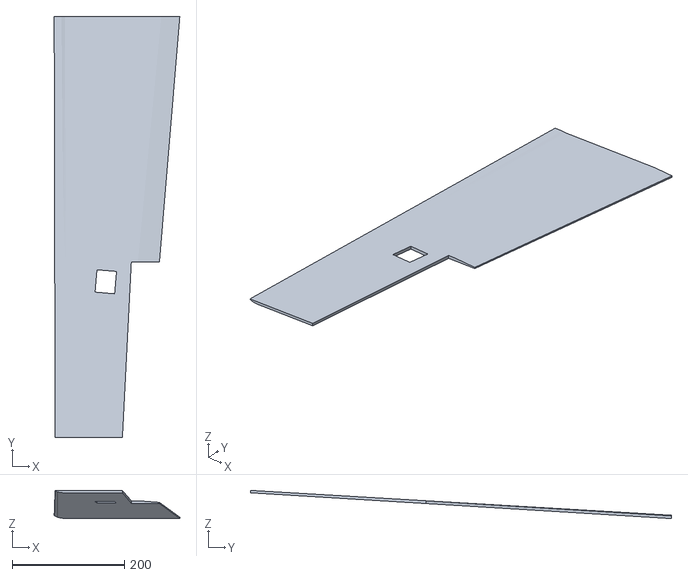
[picture p54: CAD file, 2026-11-01]
ArchivosCAD/FreeCAD/STL/W1_I.stl
223.9 x 750.0 x 50.3
