prueba2001/UAV-CONTROLADO-POR-4G-LTE/ArchivosCAD/FreeCAD/STL/Helice.stl

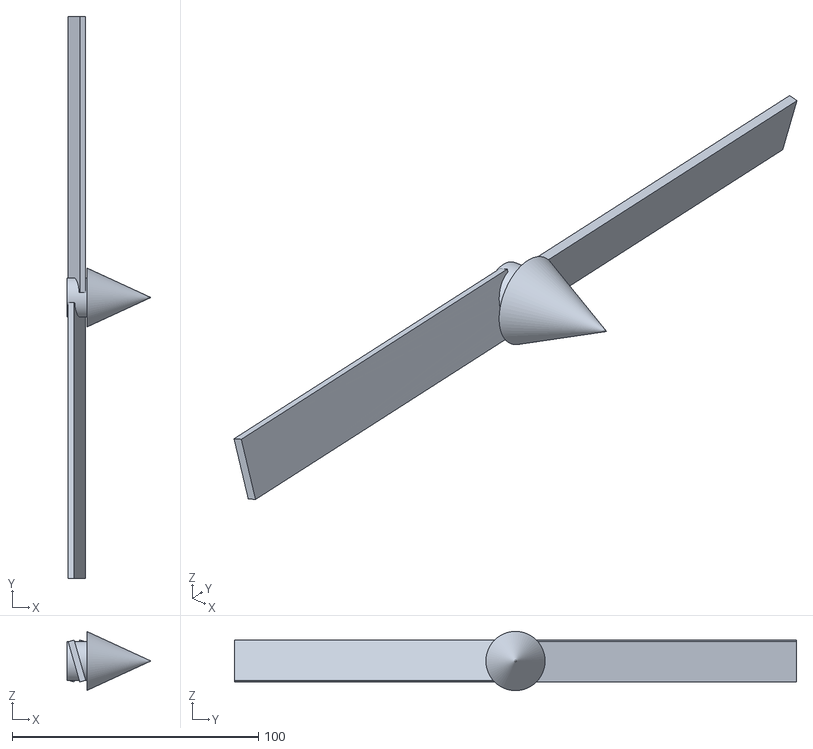
[picture p55: CAD file, 2026-11-01]
ArchivosCAD/FreeCAD/STL/Helice.stl
34.0 x 228.0 x 24.0
