prueba2001/UAV-CONTROLADO-POR-4G-LTE/ArchivosCAD/FreeCAD/STL/ESC.stl

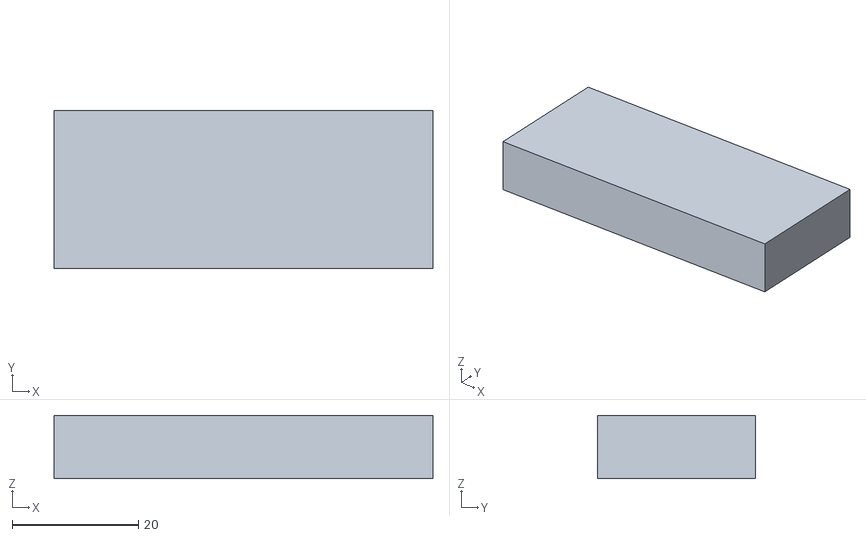
[picture p56: CAD file, 2026-11-01]
ArchivosCAD/FreeCAD/STL/ESC.stl
60.0 x 25.0 x 10.0
