prueba2001/UAV-CONTROLADO-POR-4G-LTE/ArchivosCAD/FreeCAD/STL/Bateria.stl

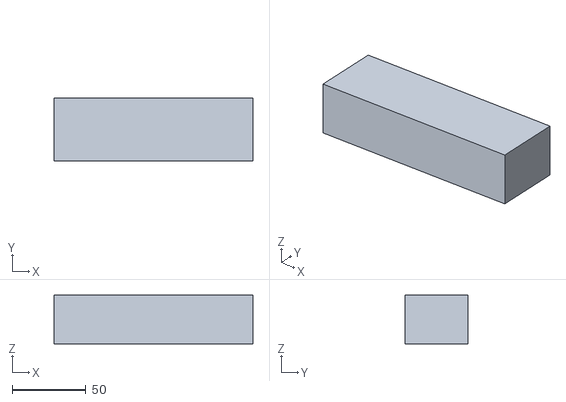
[picture p57: CAD file, 2026-11-01]
ArchivosCAD/FreeCAD/STL/Bateria.stl
135.0 x 43.0 x 33.0
