prueba2001/UAV-CONTROLADO-POR-4G-LTE/ArchivosCAD/FreeCAD/STL/W4_I.stl

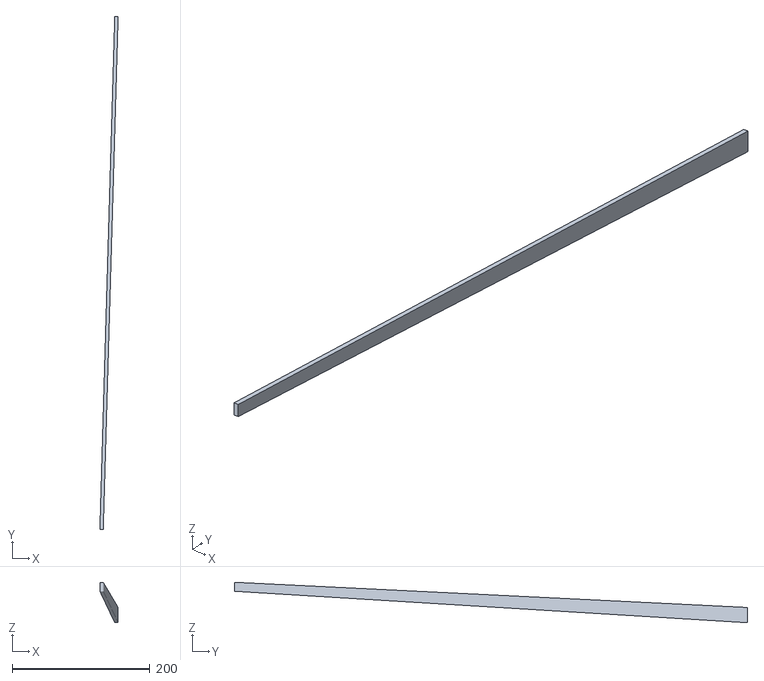
[picture p58: CAD file, 2026-11-01]
ArchivosCAD/FreeCAD/STL/W4_I.stl
26.6 x 745.0 x 58.7
