prueba2001/UAV-CONTROLADO-POR-4G-LTE/ArchivosCAD/FreeCAD/STL/F9_I.stl

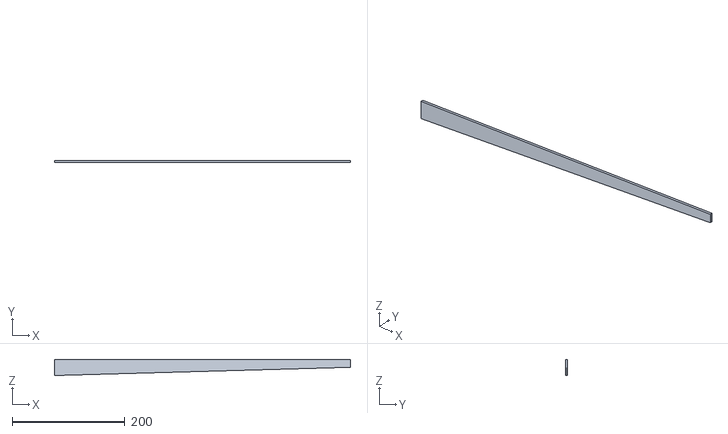
[picture p59: CAD file, 2026-11-01]
ArchivosCAD/FreeCAD/STL/F9_I.stl
525.7 x 4.00 x 28.5
