prueba2001/UAV-CONTROLADO-POR-4G-LTE/ArchivosCAD/FreeCAD/STL/Tapa.stl

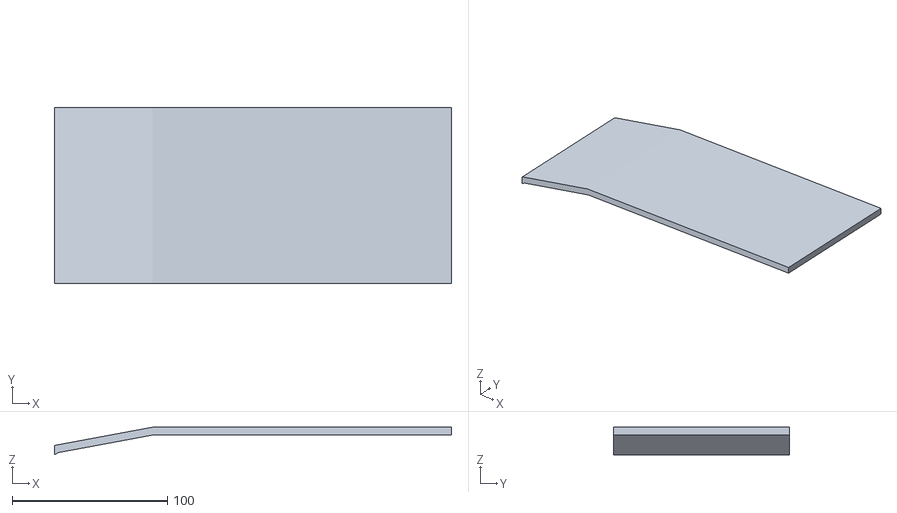
[picture p60: CAD file, 2026-11-01]
ArchivosCAD/FreeCAD/STL/Tapa.stl
256.1 x 113.6 x 17.8
