prueba2001/UAV-CONTROLADO-POR-4G-LTE/ArchivosCAD/FreeCAD/STL/Servo_timon_D.stl

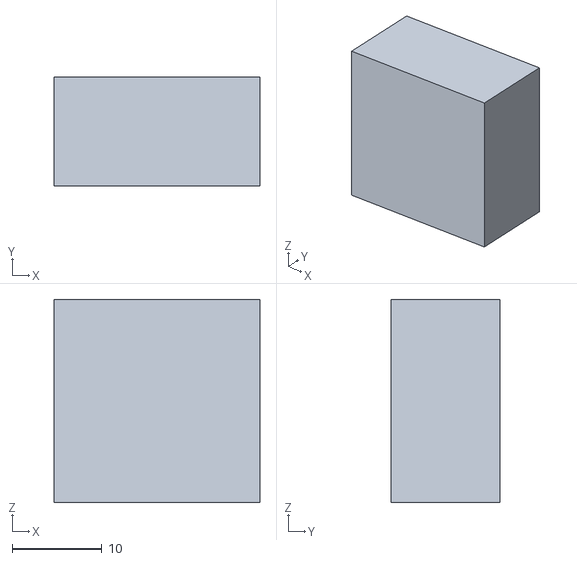
[picture p61: CAD file, 2026-11-01]
ArchivosCAD/FreeCAD/STL/Servo_timon_D.stl
23.0 x 12.2 x 22.7
