prueba2001/UAV-CONTROLADO-POR-4G-LTE/ArchivosCAD/FreeCAD/STL/W5_I.stl

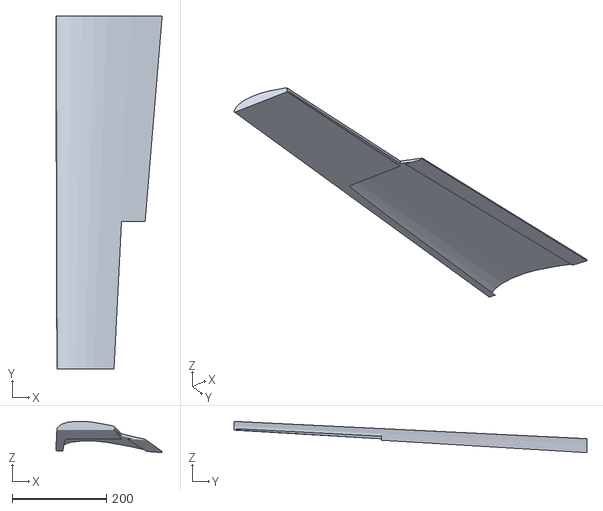
[picture p62: CAD file, 2026-11-01]
ArchivosCAD/FreeCAD/STL/W5_I.stl
226.0 x 750.0 x 66.5
