prueba2001/UAV-CONTROLADO-POR-4G-LTE/ArchivosCAD/FreeCAD/STL/F1.stl

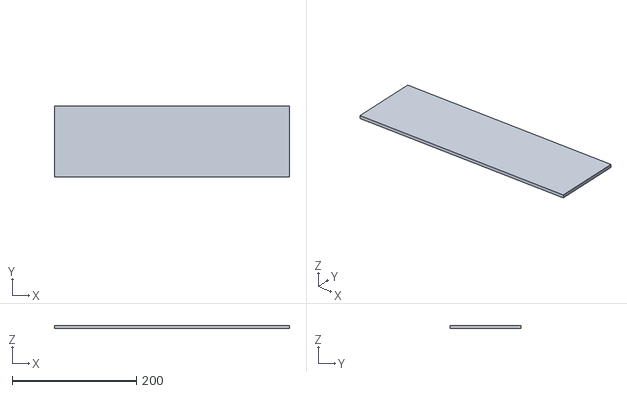
[picture p63: CAD file, 2026-11-01]
ArchivosCAD/FreeCAD/STL/F1.stl
378.3 x 113.6 x 5.20
