prueba2001/UAV-CONTROLADO-POR-4G-LTE/ArchivosCAD/FreeCAD/STL/Pico_control.stl

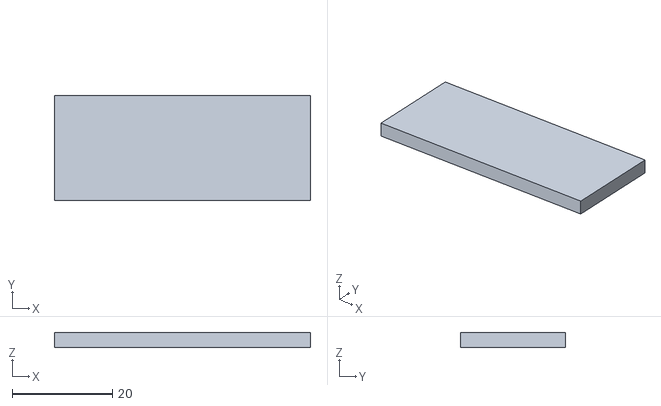
[picture p64: CAD file, 2026-11-01]
ArchivosCAD/FreeCAD/STL/Pico_control.stl
51.0 x 21.0 x 3.00
