prueba2001/UAV-CONTROLADO-POR-4G-LTE/ArchivosCAD/FreeCAD/STL/Soporte_motor.stl

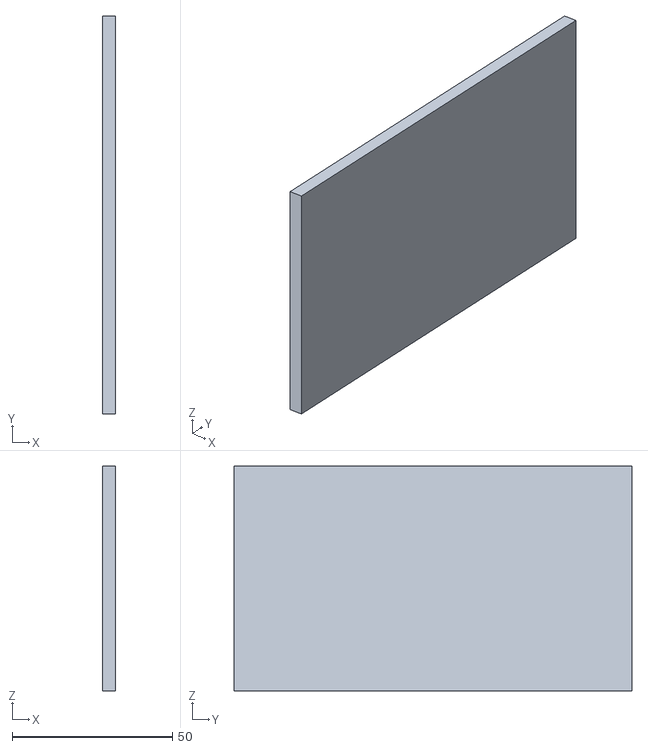
[picture p65: CAD file, 2026-11-01]
ArchivosCAD/FreeCAD/STL/Soporte_motor.stl
4.00 x 124.0 x 70.0
