prueba2001/UAV-CONTROLADO-POR-4G-LTE/ArchivosCAD/FreeCAD/STL/Modem_LTE.stl

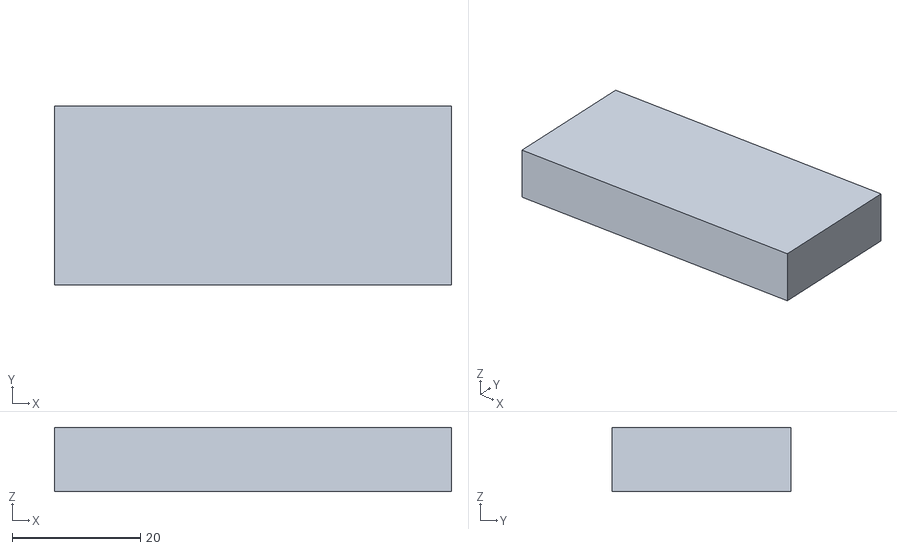
[picture p66: CAD file, 2026-11-01]
ArchivosCAD/FreeCAD/STL/Modem_LTE.stl
62.0 x 28.0 x 10.0
