prueba2001/UAV-CONTROLADO-POR-4G-LTE/ArchivosCAD/FreeCAD/STL/Disipador.stl

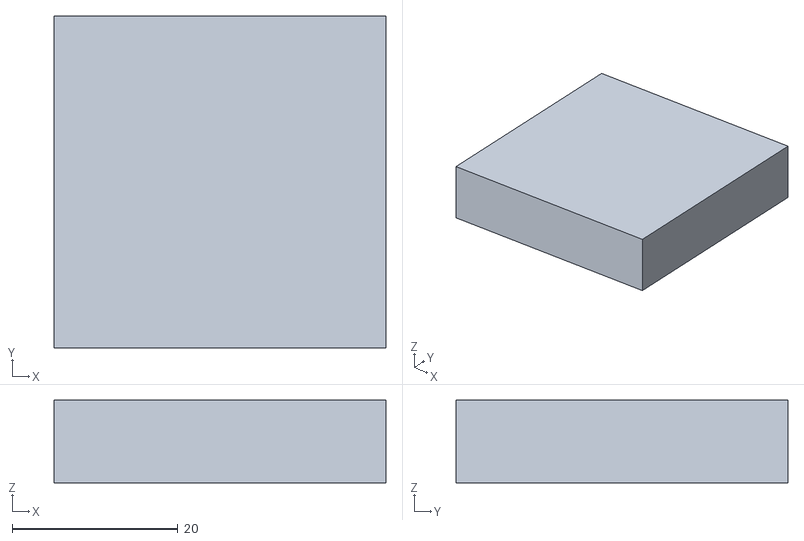
[picture p67: CAD file, 2026-11-01]
ArchivosCAD/FreeCAD/STL/Disipador.stl
40.0 x 40.0 x 10.0
