prueba2001/UAV-CONTROLADO-POR-4G-LTE/ArchivosCAD/FreeCAD/STL/Motor.stl

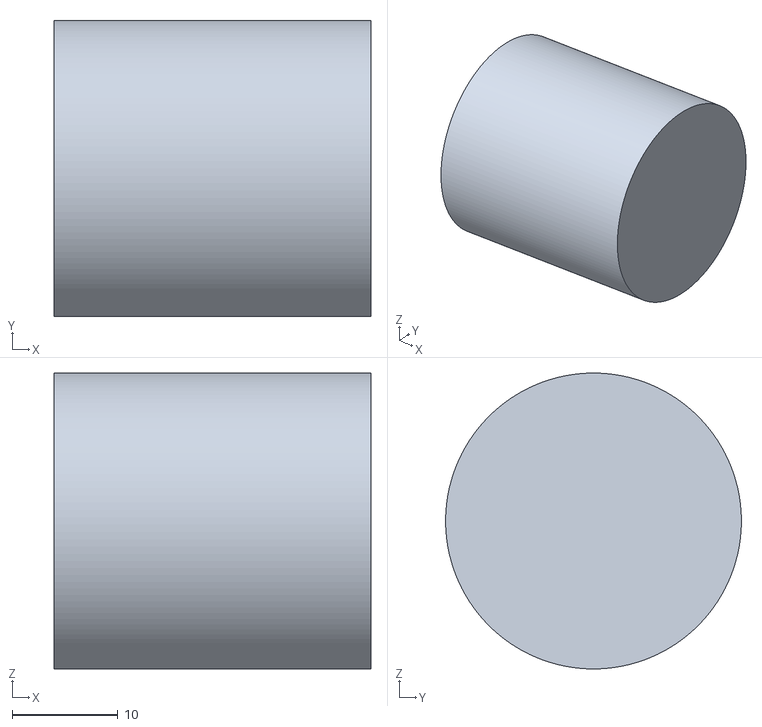
[picture p68: CAD file, 2026-11-01]
ArchivosCAD/FreeCAD/STL/Motor.stl
30.0 x 28.0 x 28.0
