prueba2001/UAV-CONTROLADO-POR-4G-LTE/ArchivosCAD/FreeCAD/STL/UBEC.stl

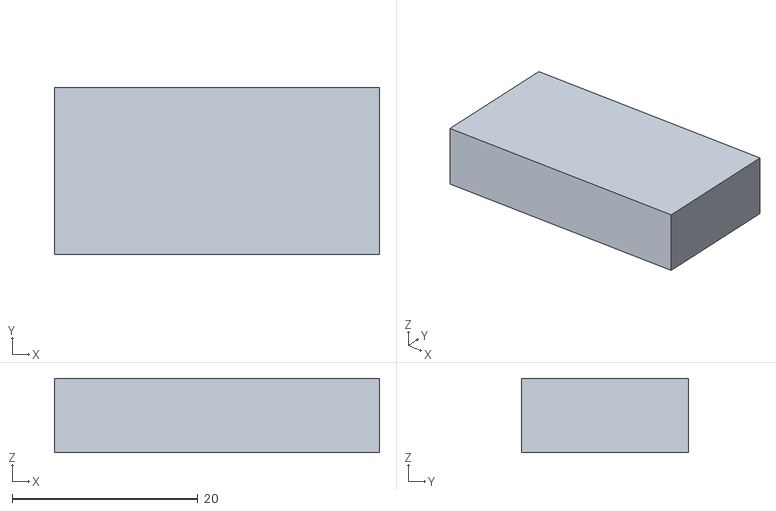
[picture p69: CAD file, 2026-11-01]
ArchivosCAD/FreeCAD/STL/UBEC.stl
35.0 x 18.0 x 8.00
