prueba2001/UAV-CONTROLADO-POR-4G-LTE/ArchivosCAD/FreeCAD/STL/OrangePi.stl

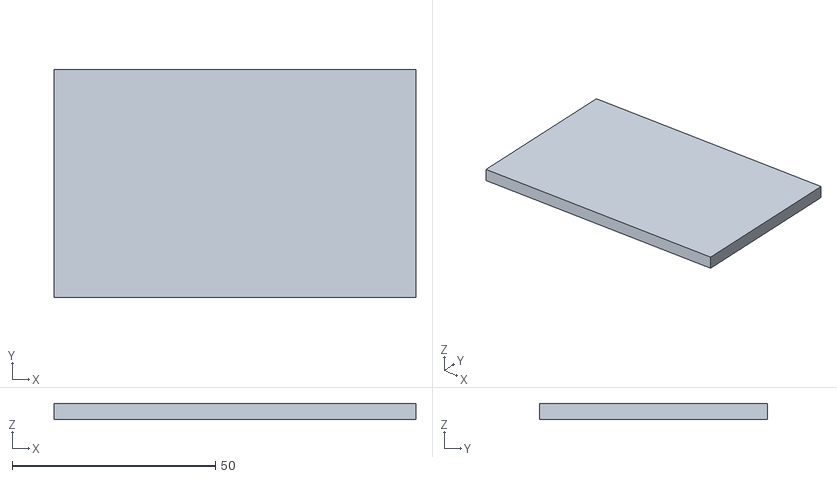
[picture p70: CAD file, 2026-11-01]
ArchivosCAD/FreeCAD/STL/OrangePi.stl
89.0 x 56.0 x 4.00
