prueba2001/UAV-CONTROLADO-POR-4G-LTE/ArchivosCAD/FreeCAD/STL/MPU6050.stl

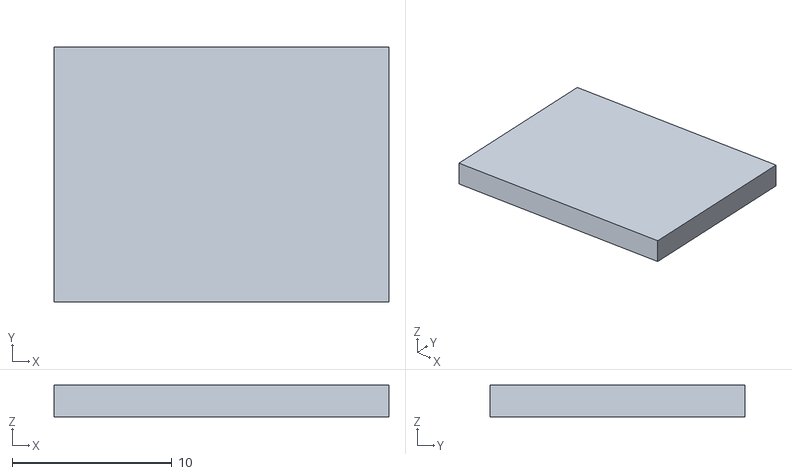
[picture p71: CAD file, 2026-11-01]
ArchivosCAD/FreeCAD/STL/MPU6050.stl
21.0 x 16.0 x 2.00
