prueba2001/UAV-CONTROLADO-POR-4G-LTE/(list of files, cad)

Other CAD files:
ArchivosCAD/FreeCAD/STL/Servo_aleron_I.stl
ArchivosCAD/FreeCAD/STL/S2_I.stl
ArchivosCAD/FreeCAD/STL/F2_I.stl
ArchivosCAD/FreeCAD/STL/W1_D.stl
ArchivosCAD/FreeCAD/STL/S4_D.stl
ArchivosCAD/FreeCAD/STL/F9_D.stl
ArchivosCAD/FreeCAD/STL/Brocheta_tras.stl
ArchivosCAD/FreeCAD/STL/Servo_timon_I.stl
ArchivosCAD/FreeCAD/STL/Servo_prof.stl
ArchivosCAD/FreeCAD/STL/W3_D.stl
ArchivosCAD/FreeCAD/STL/Pico_MQ.stl
ArchivosCAD/FreeCAD/STL/W5_D.stl
ArchivosCAD/FreeCAD/STL/W2_D.stl
ArchivosCAD/FreeCAD/STL/W4_D.stl
ArchivosCAD/FreeCAD/STL/Aleron_I.stl
ArchivosCAD/FreeCAD/Alapalap_4S.FCStd
