prueba2001/UAV-CONTROLADO-POR-4G-LTE/(commit log)

2026-10-21 Organiza el repositorio con la estructura del proyecto
    - Codigos definitivos movidos sin cambios a Resources/Software
    (firmware del Pico y del Arduino, Orange Pi y laptop)
    - Proyecto/: informe tecnico, electronica y guia de armado
    - ArchivosCAD/: DXF para CNC y planos de armado en PDF
    - Visor 3D, diagramas de flujo, pines y alimentacion
    - README principal con arquitectura, protocolo, resultados y puesta en marcha
    Claude-Session: https://claude.ai/code/session_014AMwphHKw3KR5vEERLS7NY
2026-10-21 Añade estado del arte, diagramas, cronograma y revisión del código
    - Estado del arte (PDF y DOCX, 19 páginas): precedentes de defensa y
    seguridad (Molniya, Privet-82, SYPAQ Corvo, Shahed/Geran, SkyRiper
    Minotaur, Auterion OS) y sensores de uso común en Arduino
    - 10 diagramas de electrónica y código + Gantt, en PNG y SVG
    - Cronograma editable en Excel (16 oct – 15 dic 2026)
    - docs/DIAGRAMAS.md y docs/OBSERVACIONES_Y_MEJORAS.md
    - Nuevas secciones y enlaces en los README existentes
    No se modificó ni eliminó ningún código.
    Claude-Session: https://claude.ai/code/session_01WDj9q66eBCM3JAYdeZMuYf
2026-10-21 Incluye en el estado del arte las fotos añadidas por el autor
    Se reinsertan las 9 fotos del documento enviado por el autor (Raven,
    Molniya-2R, SYPAQ Corvo, Shahed, Minotaur, Auterion y sensores MQ)
    en sus mismas posiciones, manteniendo los términos de defensa y
    seguridad.
    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
2026-10-21 Enlaza el visor 3D interactivo publicado en línea
    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
2026-11-01 Añadir modelo 3D en FreeCAD del Alapalap 4S
    Ensamble completo generado por script (alapalap_freecad.py), con
    .FCStd, .step y un STL por pieza. Diedro de 3,4° por semiala según W6.
